kavishraval8-RKT/Project-AGNI/media/3D_PCB_AGNI v3_TOP.png

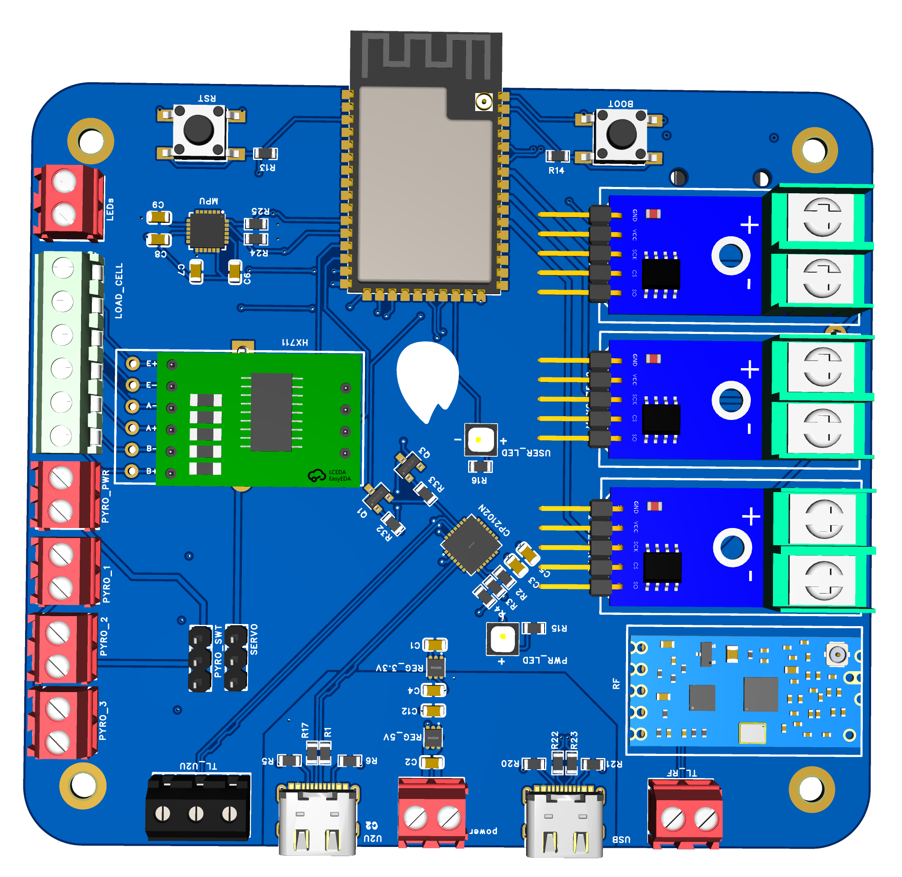
media/3D_PCB_AGNI v3_TOP.png
