kavishraval8-RKT/Project-AGNI/media/PCB_PCB_AGNI v3_2025-08-29.pdf

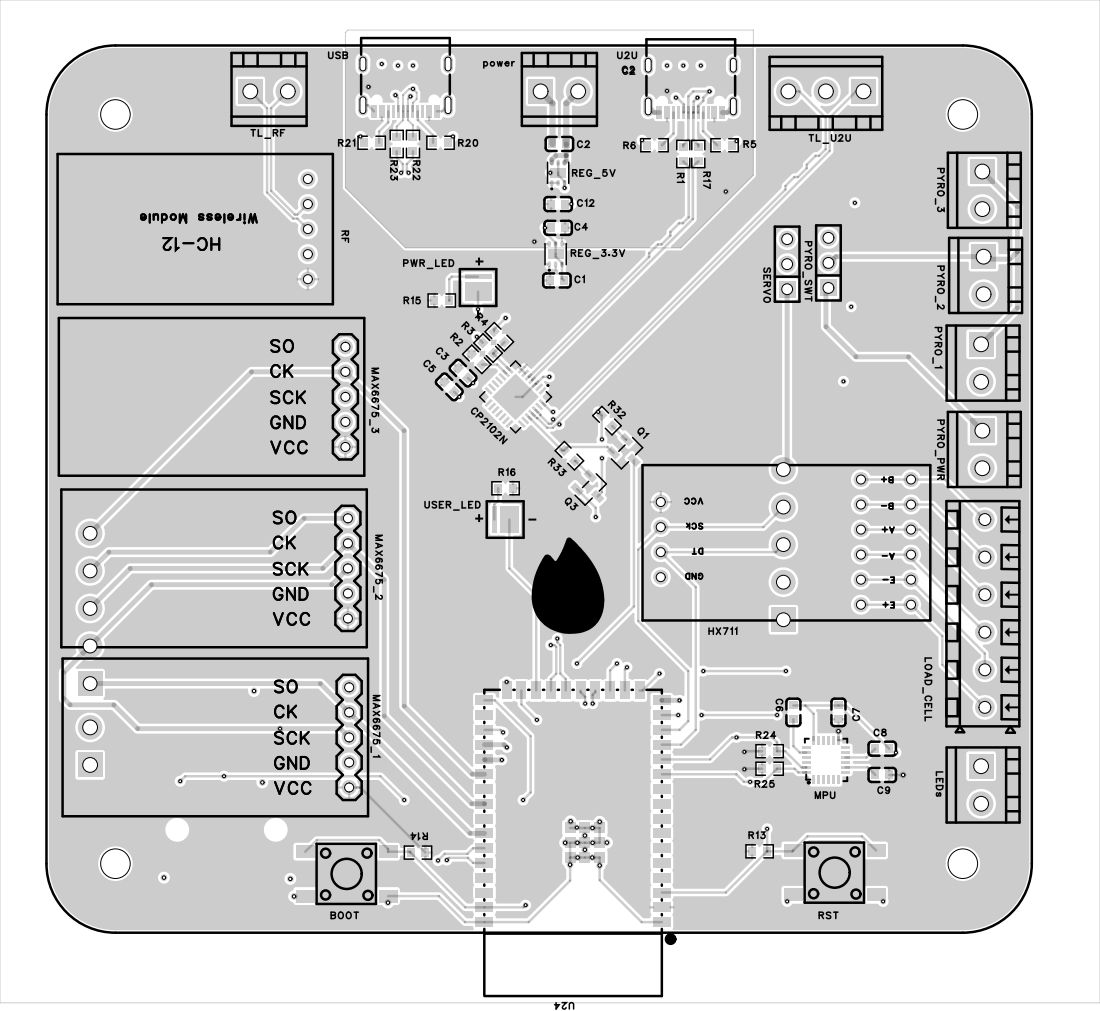
[picture p20: page 1]

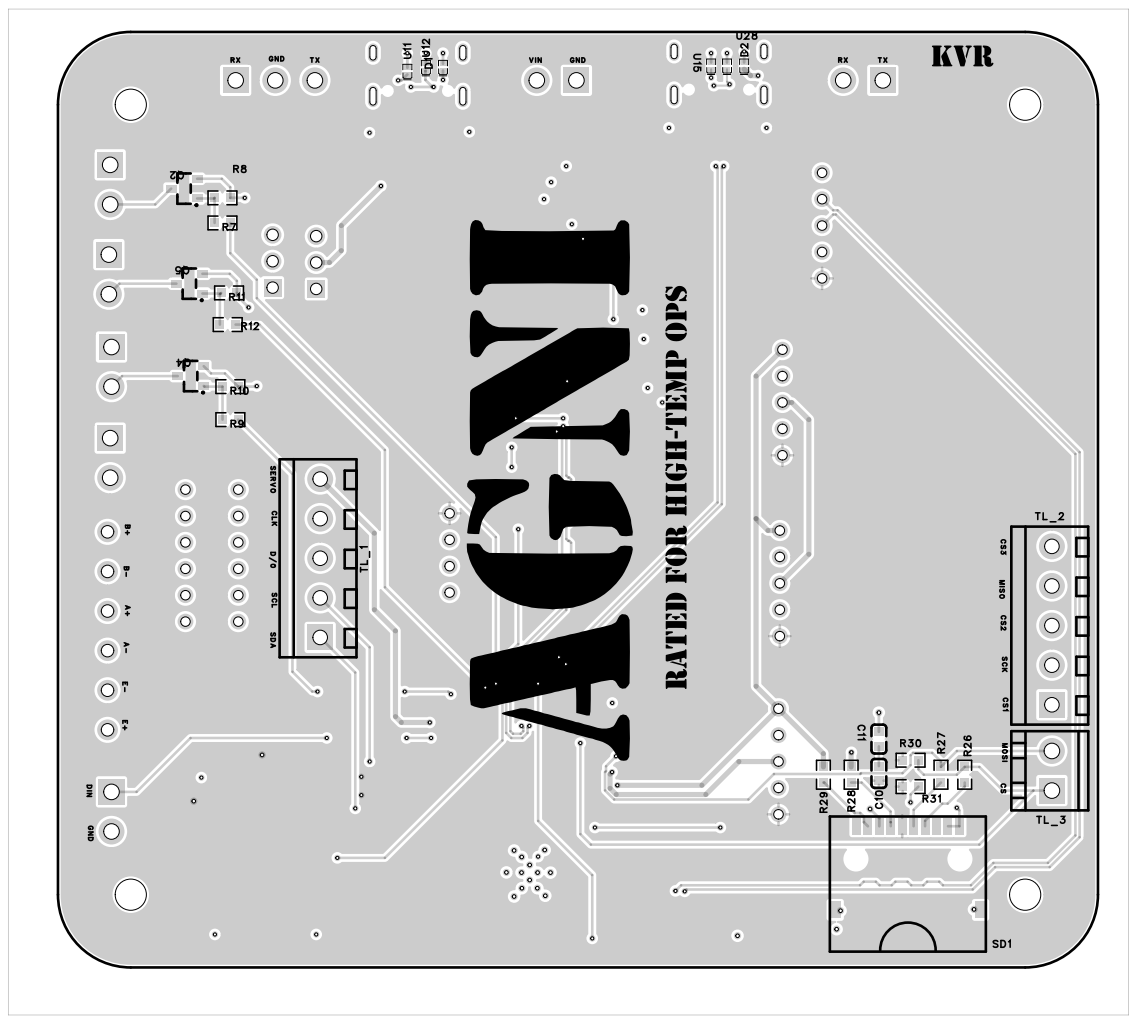
[picture p21: page 2]

AGNI Rated for High-Temp Ops

CS3 MISO CS2 SCK CS1 MOSI CS

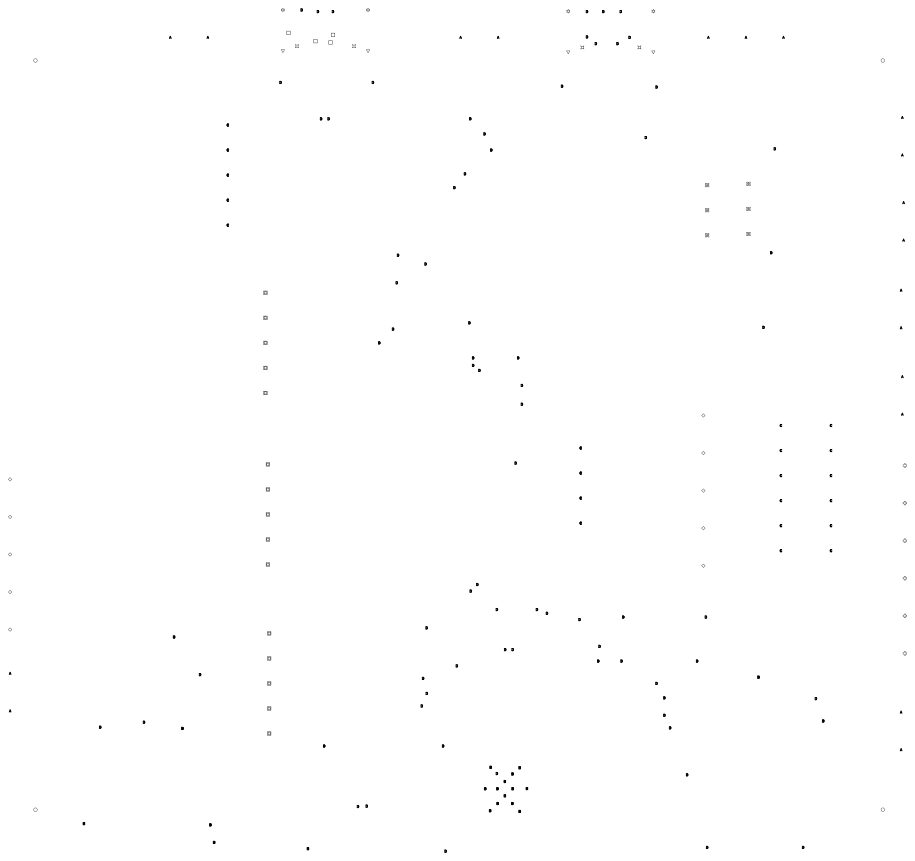
[picture p22: page 3]
